pgi512/RomWriter/hardware/BOM_AT28C64_Programmer.xlsx

ROM Writer Bill of Materials (BOM)
Source: hardware/Schematic_AT28C64_Programmer.png, hardware/Gerber_AT28C64_Programmer_PCB.zip and firmware/ROMWriter/ROMWriter.ino. Unit prices are left blank; enter your supplier's prices in the blue cells.
No. | Category | Ref. | Part / Value | Qty | Package / Notes | Unit price (KRW) | Amount (KRW)
1 | Required | - | PCB, 2-layer, 80 x 57 mm | 1 | Order with hardware/Gerber_AT28C64_Programmer_PCB.zip
2 | Required | P1 | Arduino Pro Micro (5V, ATmega32U4) | 1 | Leonardo-compatible (shows up as a COM port). Micro-USB cable not included
3 | Required | U1 | AT28C64B-15PU (8K x 8 EEPROM) | 1 | 28-pin DIP. A ZIF socket is recommended if you swap chips often
4 | Required | U2, U3 | SN74HC595N (shift register) | 2 | 16-pin DIP. Drives address lines A0~A12
5 | Optional | - | 74LS48 (BCD to 7-segment decoder) | 2 | 16-pin DIP. Labeled XD74LS48 on the schematic. For the 7-segment display
6 | Optional | SEG1, SEG2 | 7-segment display, 0.56 inch, 1 digit, common cathode | 2 | SEG-TH_0.56x1_Cathode on the schematic
7 | Optional | R1 ~ R14 | Resistor 1kΩ 1/4W | 14 | 7 per segment display x 2
8 | Socket | U1 | 28-pin DIP IC socket (or ZIF) | 1 | For swapping the EEPROM
9 | Socket | U2, U3 | 16-pin DIP IC socket | 2
10 | Socket | - | 16-pin DIP IC socket (for 74LS48) | 2 | Only if you build the optional parts
11 | Recommended | - | Bypass capacitor 0.1µF ceramic | 5 | Not on the schematic; the PCB has no footprints for them. If used, solder across each IC's VCC and GND pins (U1, U2, U3, 74LS48 x2)
 |  |  | Total
Category: Required = needed for the programmer to work / Optional = 7-segment number display (the PC program works without it; leave those footprints empty) / Socket, Recommended = build conveniences (not on the schematic)
Blue text in Qty and Unit price marks values you enter yourself.
