pgi512/RomWriter/(commit log)

2026-11-12 Initial commit: AT28C64 EEPROM programmer (firmware + Windows GUI)
    - firmware: Arduino Pro Micro sketch (ROMWriter.ino v2.0)
    - gui: Python/tkinter GUI, core library, self-test, exe build script
    - hardware: schematic (jpg, pdf) and BOM
    [BOM.xlsx]
2026-11-12 Add PCB Gerber files, replace schematic, translate BOM to English
    - hardware: add Gerber zip, replace schematic jpg/pdf with a png export
    - hardware: rename BOM and translate its contents to English
    - README: embed the schematic and list the hardware files
    [BOM.xlsx, BOM_AT28C64_Programmer.xlsx]
2026-11-12 Make the BOM and README PCB-based
    - BOM: add the PCB as item 1, drop the breadboard/perfboard item,
    note that the PCB has no bypass capacitor footprints
    - README: add PCB specs and an ordering step
    [BOM_AT28C64_Programmer.xlsx]
